Varchaswin/Biosignal-Foundry/Chip_Test_Plan.docx

# Chip Test Plan

Ultra-Low-Power Event-Driven ECG Sensor SoC (GF180MCU)

Scope: Post-silicon bench characterization, emulated-ECG functional verification, and real-time biomedical-signal evaluation

# 1. Objective and Test Strategy

This plan verifies the ECG SoC in four sequential stages: (1) DC Testing; (2) INA Block and QRS Feature Block Characterization; (3) Functional Test with Emulated Signal from AFG; and (4) Testing with Real-Time Biomedical Signal.

The planned external interfaces are analog inputs INP/INN, VREF/VBIAS, VDD_A/GND_A (nominal 3.3 V), VDD_D/GND_D (nominal 1.8 V), CLK, DET, and RR_OUT. The on-chip ADC is optional in the architecture and is not assumed to be present. External input protection, patient isolation, and safe electrode interfacing must be provided by the test fixture.

# 2. Bench Setup and Pre-Test Checks

- Equipment: two low-noise regulated supplies or SMUs (3.3V), current measurement, 2-channel synchronized AFG/AWG, oscilloscope with high-impedance/differential probes, logic analyzer or timestamp capture, precision DMM, low-noise signal analyzer/preamp, and a host PC for logging and waveform processing.
- Optional tools: temperature chamber, network/frequency-response analyzer, source-measure picoammeter, ESD-protected input fixture, and ECG patient simulator / independently recorded ECG playback system.
- Record chip ID, wafer/lot, package/board revision, temperature, reference/trim settings, clock frequency and levels, input common-mode voltage, cable configuration, firmware/decoder revision, and instrument calibration.
- Before applying power, review the final pad map, ground scheme, ESD design, power sequence, clock timing, test-point access, and RR_OUT electrical/encoding specification.

# 3. Stage I — DC Testing

Goal: confirm safe power-up and valid biasing before any dynamic waveform is applied. Begin with both ECG inputs held at the intended common-mode potential and no differential input signal.

Test ID | Procedure | Measurement / exit criterion
DC-01 | Inspect package, PCB continuity, supply-to-ground resistance and pin identification before power-on. | No shorts, reversed connections, or abnormal leakage.
DC-02 | Ramp VDD to 3.3 V with current limits; repeat permitted sequencing. | Supply currents, startup transients, stable operation; limits to be set from final simulation.
DC-03 | Measure analog and digital rail current in quiescent, clocked, and active-event states. | Total power; compare with post-layout estimates.
DC-04 | Check VREF/VBIAS response and startup, including controlled trim variation. Measure nominal BGR 1.20 V output. | Stable reference and bias; characterize 3.0–3.6 V analog supply sensitivity and startup time.
DC-05 | Sweep allowed input common mode and check DC bias/output common mode through test node if available. | Input common-mode target 0.8–2.5 V; internal CCIA output common mode near 1.65 V.
DC-06 | Check CLK input idle/static states and verify DET/RR_OUT remain valid and free of spurious toggling. | Correct digital logic levels, no unexplained event pulses.

Stage-I exit gate: stable reference and supplies, no overcurrent or abnormal heating, and reproducible clock and output states. Numeric current limits require final design signoff.

# 4. Stage II — Individual Block Characterization

Goal: compare the measured behavior of the available blocks or monitor structures with the design targets. Where direct access is unavailable, validate only the achievable system-level proxy and document the coverage gap.

Block | Bench stimulus / measurement | PPT specification or baseline
BGR-01 | At nominal 3.3 V analog supply, measure V_BGR with a high-impedance DMM and scope. Record settling time, startup overshoot, and repeatability across power cycles. | Nominal BGR ≈ 1.20 V. Record measured steady-state value and startup time; allowable tolerance is not specified in the PPT.
BGR-02 | Sweep VDD from 3.0 to 3.6 V, while maintaining permitted digital conditions. Measure V_BGR versus supply and calculate ΔV_BGR/ΔVDD_A. | PPT simulation: 1.185–1.219 V across 3.0–3.6 V, about 56.7 mV/V. This is a simulated baseline, not a formally approved limit.
BGR-03 | Repeat V_BGR measurement in a controlled temperature chamber over the package-approved test range; repeat a nominal-supply check at each temperature. | PPT simulation: about 12 mV change and ~57 ppm/°C endpoint coefficient from −50 to 125 °C. Use only the safe/qualified temperature span in the experiment.
BGR-04 | Check BGR output sensitivity to small supply ripple and measurement-probe loading, if the BGR pin is designed to drive an external instrument. | Measure line-noise coupling and disturbance qualitatively; no PSRR or load-regulation acceptance value is provided.
INA-01 | Apply a low-distortion differential sine wave (e.g., 1 mVpp at 10 Hz) around the specified input common mode; measure differential INA output amplitude and output common mode. | PPT target: 40 dB gain; chopped-INA simulation: 49.6 V/V (~33.9 dB) and output common mode ~1.65 V. Reconcile target versus simulation before pass/fail.
INA-02 | Sweep input frequency from below 0.05 Hz to above 150 Hz (e.g., 0.01–500 Hz) at a non-saturating amplitude; measure gain and phase (where practical) using INA output. | PPT CCIA passband target: 0.05–150 Hz. Report measured high-/low-frequency −3 dB corners; do not equate these with the inaccessible downstream BPF.
INA-03 | Sweep differential input amplitude from 0.1 to 5 mV within the supported operating range; record gain linearity, clipping and maximum undistorted output swing. | PPT input differential range: 0.1–5 mV; output swing target: 1 V. Clarify whether output swing is differential or per side.
INA-04 | Sweep input common-mode voltage from 0.8 to 2.5 V; separately apply controlled DC differential electrode offsets up to ±300 mV if safe and allowed. Superimpose a small ECG-band AC tone and monitor recovery/saturation. | PPT: input common mode 0.8–2.5 V, electrode DC offset tolerance ±300 mV, output common mode ~1.65 V. Respect all pin absolute-maximum ratings.
INA-05 | Measure differential gain and common-mode gain with balanced input drive at representative ECG-band frequencies, including 50/60 Hz; calculate CMRR = 20 log10(|A_diff/A_CM|). | PPT CMRR target >90 dB. Calibrate source balance, cable mismatch, and the analyzer noise floor; otherwise report an instrument-limited lower bound.
INA-06 | With the inputs shorted together and biased at valid common mode, measure INA output-noise density and integrated ECG-band RMS noise; refer noise back to the input using measured closed-loop gain. | PPT input-referred noise target <200 nV/√Hz (frequency/band definition unspecified). Separate broadband noise, low-frequency components, and any chopper-related tones.
INA-07 | Use guarded, calibrated source impedance or a current-injection fixture to estimate INA input impedance at selected low frequencies; quantify probe and cable parasitics. | PPT input-impedance target ~1 GΩ; simulation reports 3.36 + j2.48 GΩ. If fixture uncertainty dominates, report an estimate/lower bound, not a definitive pass.

Stage-II exit gate: obtain repeatable BGR reference/line/temperature data and INA transfer function, operating range, noise, and interference rejection, with clearly recorded comparisons to both the PPT targets and simulation baselines. Confirm that simple QRS-like stimuli produce plausible DET/RR_OUT activity as a screening check only; reserve sensitivity, timing accuracy, and comprehensive R-R testing for Stage III. Do not mark inaccessible internal blocks as independently passed.

# 5. Stage III — Functional Test with Emulated Signal from AFG

Goal: verify the complete signal chain under repeatable ECG and interference conditions. Generate an ECG-like differential waveform using synchronized AFG channels or a differential driver, with INP = VCM + vECG/2 and INN = VCM − vECG/2; use a nominal VCM of 1.65 V unless the final analog input requirements dictate otherwise. Avoid unintended ground loops.

1. Nominal sinusoidal check. Confirm basic gain / filtering response at representative ECG frequencies before switching to complex waveforms. Capture supply current and DET/RR_OUT behavior.

2. Synthetic ECG playback. Program QRS/P/T morphology at 40, 60, 90, 120, and 180 bpm and known ground-truth R-peak timestamps. Exercise differential input amplitudes over the specified 0.1–5 mV range.

3. R-R timing and transitions. Use fixed, irregular and step-changing R-R sequences, including closely spaced beats. Record pulse timestamps and decode RR_OUT using the final interface protocol.

4. Robustness checks. Introduce controlled baseline wander, 50/60 Hz interference, broadband / EMG-like noise, input common-mode variations, electrode-offset disturbances, QRS morphology changes, and prominent T-waves. Sweep threshold/bias settings if supported.

5. Power characterization. Measure rail current in no-event, slow-beat, fast-beat, and interference cases, and estimate average power and energy per valid detected event.

Required outputs: DET pulse count and timestamps; decoded R-R data; true positives (TP), false positives (FP), missed beats (FN); sensitivity = TP/(TP+FN), positive predictive value = TP/(TP+FP), absolute R-R error, latency, jitter, and current/power traces. Acceptance limits for detection quality and timing are to be agreed before execution; the PPT does not provide them.

Stage-III exit gate: reliable detection and R-R reporting across the agreed ECG operating range, with a reproducible error and power budget.

# 6. Stage IV — Testing with Real-Time Biomedical Signal

Goal: assess performance on realistic ECG morphologies, electrode conditions and motion artifacts, while comparing against a synchronized reference ECG device. Begin with previously recorded signals replayed through an ECG simulator; progress to live participants only after the required institutional safety review and equipment checks.

1. Prepare patient-safe acquisition. Use a medically appropriate, electrically isolated, battery-powered subject interface and external input protection. Never connect ordinary earth-referenced bench instruments directly to a participant.

2. Acquire synchronized reference ECG. Record a reference ECG and the chip’s DET and RR_OUT concurrently. Log timing alignment, supply conditions, electrode placement and signal quality.

3. Run representative conditions. Collect resting sitting, standing, controlled breathing, light movement/walking, and deliberate electrode-motion periods as permitted by the approved setup.

4. Analyze detection performance. Annotate or algorithmically verify ground-truth R-peaks using the reference ECG, apply a documented matching window, and calculate sensitivity, positive predictive value, R-R mean absolute error, beat-to-beat timing error, and failure cases by condition.

5. Assess stability and power. Track false detections during motion, bias drift, missed beats, interference sensitivity, clock stability, mean power consumption, and recoverability after electrode reconnection.

Stage-IV exit gate: reproducible real-world performance relative to the reference ECG, with clearly stated subject/sample size, test conditions, limits and observed failure modes. Human testing must remain non-diagnostic unless separately validated and authorized.

# 7. Test Data, Reporting, and Sign-Off

- Store raw AFG patterns, instrument captures, reference ECG, DET/RR_OUT logs, calibration records, and the processing script/version for every test run.
- For each test, report: test ID; device ID; setup; stimulus; measured value; design target/simulation baseline; pass/fail/blocked; and deviation comments.
- Summarize analog supply power, digital supply power, reference stability, CCIA gain and noise, filter response, R-peak sensitivity/precision, R-R error, timing jitter, and performance under motion.
- Release gates should distinguish (a) published design targets, (b) current simulation results, and (c) newly proposed post-silicon acceptance thresholds.

Draft for engineering review • 1

GF180MCU | ECG Sensor SoC | Engineering Test Plan
