Varchaswin/Biosignal-Foundry/(commit log)

2026-06-12 Add files via upload
    Project Proposal: [Team B8 Biosignal Foundry] Ultra-Low-Power ECG Sensor SoC with Analog R-Peak Detection
2026-07-08 Revise README for ECG sensor project details
    Updated descriptions for ECG sensor project, emphasizing R-peak detection and analog processing. Revised key features, motivation, and system architecture sections for clarity and detail.
2026-07-24 Enhance README with project resource links
    Added links to schematic, progress tracker, and layout updates in the README.
2026-08-08 Modify project team and update description and config
    Updated project metadata for the ECG sensor SoC.
